swisscheese38/rtklawnmower/catkin_ws/src/rtklm_description/models/chassis.stl

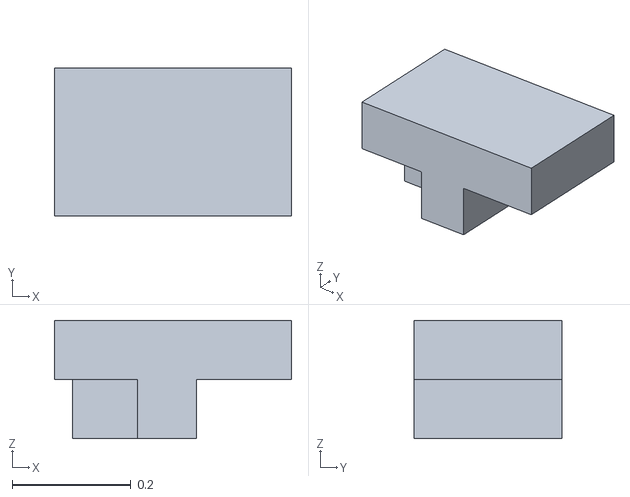
[picture p1: CAD file, 2022-12-20, last stored version]
catkin_ws/src/rtklm_description/models/chassis.stl
0.4 x 0.25 x 0.2
