swisscheese38/rtklawnmower/catkin_ws/src/rtklm_description/models/wheel.stl

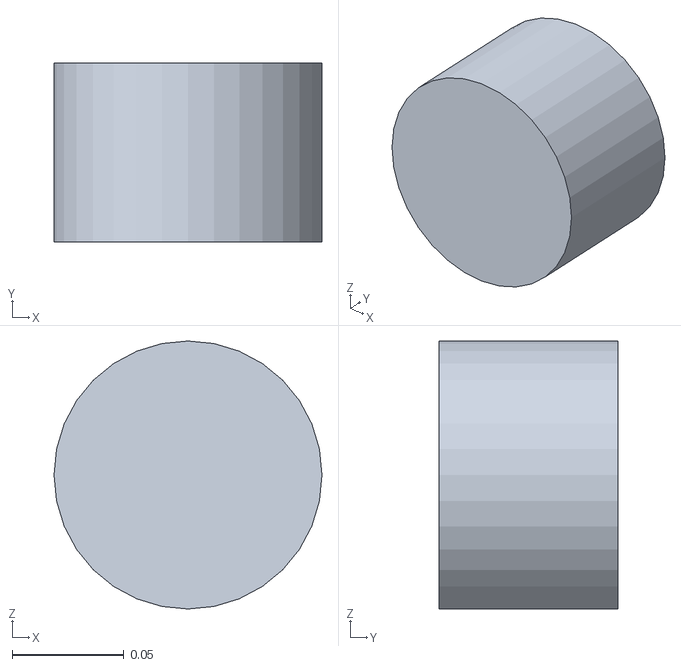
[picture p2: CAD file, 2022-12-20, last stored version]
catkin_ws/src/rtklm_description/models/wheel.stl
0.12 x 0.08 x 0.12
