swisscheese38/rtklawnmower/(commit log)

2022-12-16 WIP Arduino code for motor driver
2022-12-20 Started some experimenting with ROS according to a Youtube tutorial
    [chassis.stl, model.urdf, wheel.stl]
2022-12-20 Corrected according to tutorial
    [model.urdf]
2022-12-20 use diffdrive controller
    [model.urdf]
2022-12-21 Use ROS diffdrive controller in Gazebo
    [model.urdf]
2022-12-21 Optimized caster wheels
    [model.urdf]
2022-12-21 Simplify by using a little xacro
    [model.urdf]
2022-12-21 split model into different components
    [casterwheel.xacro, main.xacro, model.urdf, wheel.xacro]
2022-12-22 Limit wheel joint efforts to they don't implode to origin and adjust Gazebo parameters so rover will not slip
    [casterwheel.xacro, chassis.xacro, main.xacro, wheel.xacro]
2022-12-22 Predefined rviz view config in roslaunch config
    [main.xacro]
2022-12-22 Move controller config to own package
    [wheel.xacro]
2022-12-22 Started on the ROS to Arduino hardware interface
2022-12-23 Calculate encoder rate
2022-12-23 Gradually adjust PWM
2022-12-23 Simpler PWM adjust function
2022-12-23 Use exact tick record time for more accurate encoder values
2022-12-23 Only output ticks, handle left and right motors
2022-12-24 Output position in radian and velocity in radian per second
2022-12-30 First tries with ROS on real hardware
    [wheel.xacro]
2022-12-30 Documented ros packages for minimal setup on Raspberry Pi
2022-12-30 Tried out to use ESP32 instead of Arduino Nano because it has internal pulldown resistors
2022-12-31 Added serial communication (does not work yet)
    [rtklm_hardware_node.cpp]
2023-01-01 Read and parse position and velocity information from Arduino
2023-01-03 Change API to ticks instead of radians, adjust PWM for consistent tick frequency
2023-01-08 Integrated with Arduino
    [wheel.xacro]
2023-01-09 Implemented Arduino sketch as a PID controller
2023-01-09 Too low speeds disturb the motor driver
    [arduino_rtklm.ino]
2023-01-12 Don't do PID (direction handling missing)
    [arduino_rtklm.ino]
2023-01-14 API to Arduino only based on speed, negate one of the motors
2023-01-15 Start using the MPU9250 IMU
2023-01-15 Turn on builtin LED for 100ms after having received an input command (this makes debugging with ROS easier)
2023-01-16 Integrate IMU
2023-01-29 Localization will fuse GPS, Odometry and IMU data
2023-01-29 Calculate position using given velocity
2023-01-29 Node that will use I2C to communicate with IMU and TF sensors
2023-01-30 Cannot access I2C exclusively for IMU
2023-01-30 Make use of smbus2 to communicate over I2C
2023-01-30 Use imusensor python library to read data from IMU
2023-01-30 Publish IMU data
2023-03-23 Switch IMU from MPU9250 to BNO055
2023-03-23 Adjusted IMU's launch config
2023-03-29 Added imu_link to model
    [imu.xacro, main.xacro]
2023-04-01 Add state publisher for transforms, prepare localization
    [imu.xacro, main.xacro]
2023-04-02 Add udev rules for permanent USB device names
2023-04-02 Only fuse wheel odometry and IMU for now, no GPS yet
2023-04-03 Corrected wrong position calculation
    [rtklm_arduino_node.cpp]
2023-04-03 Increase sampling to 10Hz, avoid NaN speed readings
    [arduino_rtklm.ino]
2023-04-03 Make LED blink duration depend on sampling period
2023-04-03 Remove gazebo config, adjust to 10Hz Arduino node
    [casterwheel.xacro, chassis.stl, chassis.xacro, imu.xacro, main.xacro, wheel.stl, wheel.xacro]
2023-04-06 Publish tf only from odometry, IMU needs calibration handling
2023-04-06 Periodically check for valid IMU calibration
2023-04-08 Store IMU calibration
2023-04-08 Use yaw from IMU, velocities from odometry
2023-04-09 Use correct BNO055 sensor units, remove outliers
    [rtklm_i2c_node.py]
2023-04-09 Enable GPS fusion for map to odom transform
    [gps.xacro, main.xacro]
2023-05-15 IMU covariance fix
